julbouln/lifepo4_ups/README

5V/2A LTC4040 and STM32F042/STM32F070 based Lifepo4 UPS

https://www.analog.com/media/en/technical-documentation/data-sheets/4040fb.pdf
https://www.st.com/resource/en/datasheet/stm32f042k6.pdf
