julbouln/lifepo4_ups/hardware/lifepo4_mini_psu.kicad_pcb

## KiCad design hardware/lifepo4_mini_psu.kicad_pcb (2020-08-30)

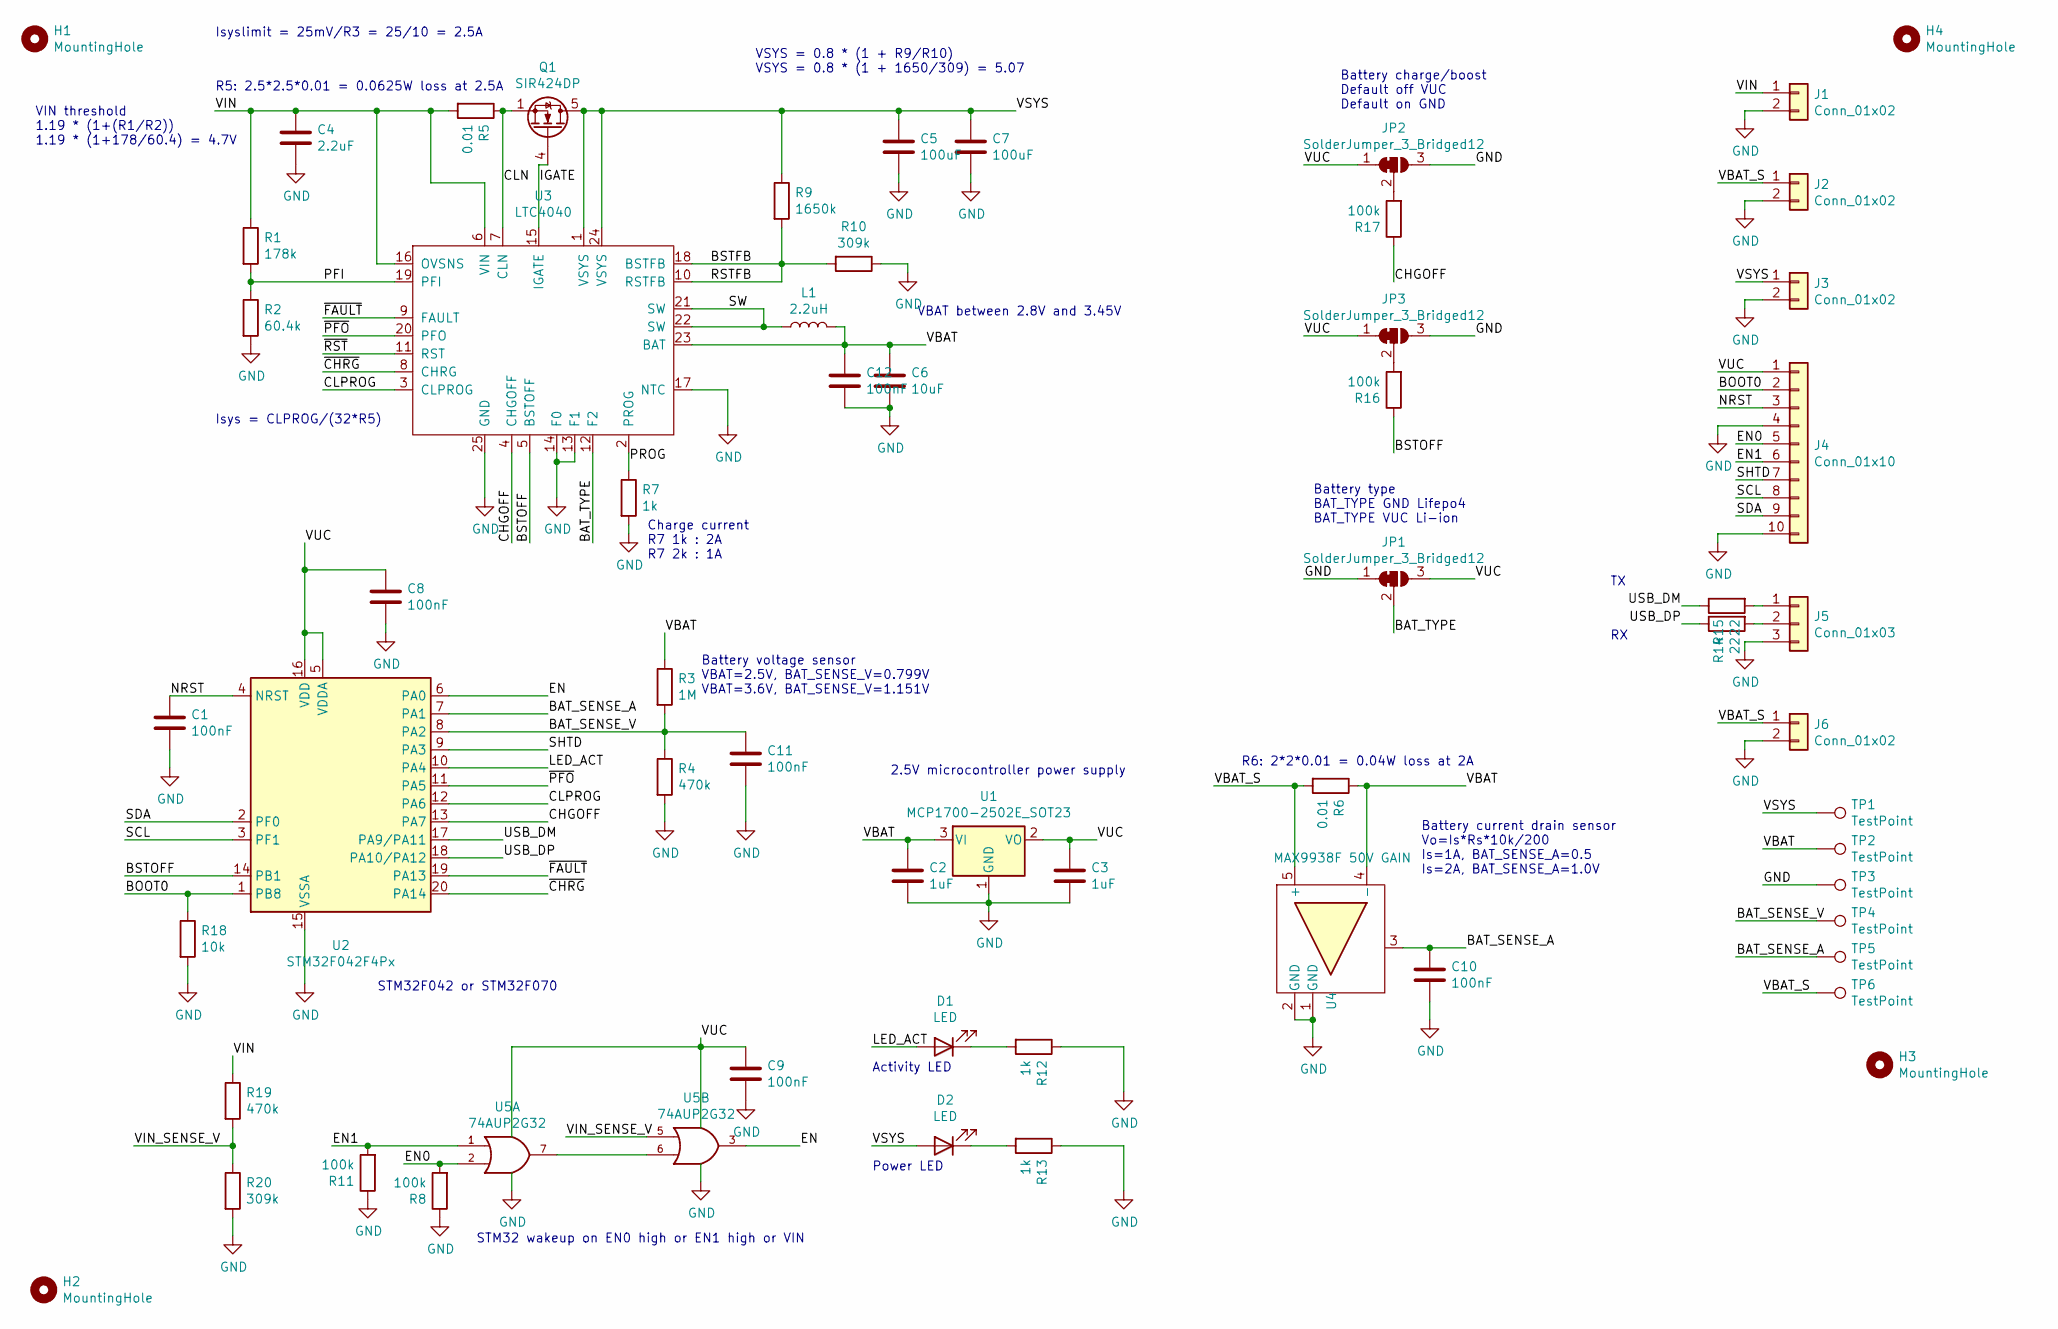
[picture p1: schematic lifepo4_mini_psu.sch, Lifepo4 UPS]

Parts:
C1, C8, C9, C10, C11, C12: 100nF; C_0603_1608Metric_Pad1.05x0.95mm_HandSolder
C2, C3: 1uF; C_0603_1608Metric_Pad1.05x0.95mm_HandSolder
C4: 2.2uF; C_0603_1608Metric_Pad1.05x0.95mm_HandSolder
C5, C7: 100uF; C_1210_3225Metric_Pad1.42x2.65mm_HandSolder
C6: 10uF; C_0603_1608Metric_Pad1.05x0.95mm_HandSolder
D1, D2: LED; LED_0603_1608Metric_Pad1.05x0.95mm_HandSolder
H1, H2, H3, H4: MountingHole; MountingHole_2.7mm_M2.5
J1, J2, J3, J6: Conn_01x02; PinHeader_1x02_P2.54mm_Vertical
J4: Conn_01x10; PinHeader_1x10_P2.54mm_Vertical
J5: Conn_01x03; PinHeader_1x03_P2.54mm_Vertical
JP1, JP2, JP3: SolderJumper_3_Bridged12; SolderJumper-3_P1.3mm_Bridged12_RoundedPad1.0x1.5mm
L1: 2.2uH; L_Coilcraft_XAL5030
Q1: SIR424DP; PowerPAK_SO-8_Single
R1: 178k; R_0603_1608Metric_Pad1.05x0.95mm_HandSolder
R2: 60.4k; R_0603_1608Metric_Pad1.05x0.95mm_HandSolder
R3: 1M; R_0603_1608Metric_Pad1.05x0.95mm_HandSolder
R4, R19: 470k; R_0603_1608Metric_Pad1.05x0.95mm_HandSolder
R5, R6: 0.01; R_1206_3216Metric_Pad1.42x1.75mm_HandSolder
R7, R12, R13: 1k; R_0603_1608Metric_Pad1.05x0.95mm_HandSolder
R8, R11, R16, R17: 100k; R_0603_1608Metric_Pad1.05x0.95mm_HandSolder
R9: 1650k; R_0603_1608Metric_Pad1.05x0.95mm_HandSolder
R10, R20: 309k; R_0603_1608Metric_Pad1.05x0.95mm_HandSolder
R14, R15: 22; R_0603_1608Metric_Pad1.05x0.95mm_HandSolder
R18: 10k; R_0603_1608Metric_Pad1.05x0.95mm_HandSolder
TP1, TP2, TP3, TP4, TP5, TP6: TestPoint; TestPoint_THTPad_D1.0mm_Drill0.5mm
U1: MCP1700-2502E_SOT23; SOT-23
U2: STM32F042F4Px; TSSOP-20_4.4x6.5mm_P0.65mm
U3: LTC4040; QFN-24-1EP_4x5mm_P0.5mm_EP2.65x3.65mm
U4: MAX9938F 50V GAIN; SOT-23-5
U5: 74AUP2G32; VSSOP-8_2.3x2mm_P0.5mm

Connections:
/BAT_SENSE_A: C10.1, TP5.1, U2.7 (PA1), U4.3
/BAT_SENSE_V: C11.1, R3.2, R4.1, TP4.1, U2.8 (PA2)
/BAT_TYPE: JP1.2 (C), U3.12 (F2)
/BOOT0: J4.2, R18.1, U2.1 (PB8)
/BSTFB: R9.2, R10.2, U3.10 (RSTFB), U3.18 (BSTFB)
/BSTOFF: R16.1, U2.14 (PB1), U3.5 (BSTOFF)
/CHGOFF: R17.1, U2.13 (PA7), U3.4 (CHGOFF)
/CLN: Q1.1 (S), Q1.2 (S), Q1.3 (S), R5.1, U3.7 (CLN)
/CLPROG: U2.12 (PA6), U3.3 (CLPROG)
/EN: U2.6 (PA0), U5.3
/EN0: J4.5, R8.2, U5.2
/EN1: J4.6, R11.2, U5.1
/IGATE: Q1.4 (G), U3.15 (IGATE)
/LED_ACT: D1.2 (A), U2.10 (PA4)
/NRST: C1.1, J4.3, U2.4 (NRST)
/PFI: R1.2, R2.1, U3.19 (PFI)
/PROG: R7.1, U3.2 (PROG)
/SCL: J4.8, U2.3 (PF1)
/SDA: J4.9, U2.2 (PF0)
/SHTD: J4.7, U2.9 (PA3)
/SW: L1.1, U3.21 (SW), U3.22 (SW)
/USB_DM: R15.1, U2.17 (PA9/PA11)
/USB_DP: R14.1, U2.18 (PA10/PA12)
/VBAT: C2.1, C6.1, C12.1, L1.2, R3.1, R6.1, TP2.1, U1.3 (VI), U3.23 (BAT), U4.4 (-)
/VBAT_S: J2.1, J6.1, R6.2, TP6.1, U4.5 (+)
/VIN: C4.1, J1.1, R1.1, R5.2, R19.1, U3.6 (VIN), U3.16 (OVSNS)
/VIN_SENSE_V: R19.2, R20.1, U5.5
/VSYS: C5.1, C7.1, D2.2 (A), J3.1, Q1.5 (D), R9.1, TP1.1, U3.1 (VSYS), U3.24 (VSYS)
/~CHRG: U2.20 (PA14), U3.8 (CHRG)
/~FAULT: U2.19 (PA13), U3.9 (FAULT)
/~PFO: U2.11 (PA5), U3.20 (PFO)
/~RST: U3.11 (RST)
GND: C1.2, C2.2, C3.2, C4.2, C5.2, C6.2, C7.2, C8.2, C9.2, C10.2, C11.2, C12.2, J1.2, J2.2, J3.2, J4.4, J4.10, J5.3, J6.2, JP1.1 (A), JP2.3 (B), JP3.3 (B), R2.2, R4.2, R7.2, R8.1, R10.1, R11.1, R12.1, R13.1, R18.2, R20.2, TP3.1, U1.1 (GND), U2.15 (VSSA), U3.13 (F1), U3.14 (F0), U3.17 (NTC), U3.25 (GND), U4.1 (GND), U4.2 (GND), U5.4 (GND)
unnamed: D1.1 (K), R12.2
unnamed: D2.1 (K), R13.2
unnamed: J5.1, R15.2
unnamed: J5.2, R14.2
unnamed: JP2.2 (C), R17.2
unnamed: JP3.2 (C), R16.2
unnamed: U5.6, U5.7
VCC: C3.1, C8.1, C9.1, J4.1, JP1.3 (B), JP2.1 (A), JP3.1 (A), U1.2 (VO), U2.5 (VDDA), U2.16 (VDD), U5.8 (VCC)

Notes on the sheet:
Charge current R7 1k : 2A R7 2k : 1A
Isyslimit = 25mV/R3 = 25/10 = 2.5A
VBAT between 2.8V and 3.45V
Isys = CLPROG/(32*R5)
Battery voltage sensor VBAT=2.5V, BAT_SENSE_V=0.799V VBAT=3.6V, BAT_SENSE_V=1.151V
Battery current drain sensor Vo=Is*Rs*10k/200 Is=1A, BAT_SENSE_A=0.5 Is=2A, BAT_SENSE_A=1.0V
Battery charge/boost Default off VUC Default on GND
R6: 2*2*0.01 = 0.04W loss at 2A
R5: 2.5*2.5*0.01 = 0.0625W loss at 2.5A
VIN threshold 1.19 * (1+(R1/R2)) 1.19 * (1+178/60.4) = 4.7V
VSYS = 0.8 * (1 + R9/R10) VSYS = 0.8 * (1 + 1650/309) = 5.07
2.5V microcontroller power supply
STM32 wakeup on EN0 high or EN1 high or VIN
Power LED
Activity LED
Battery type BAT_TYPE GND Lifepo4 BAT_TYPE VUC Li-ion
STM32F042 or STM32F070

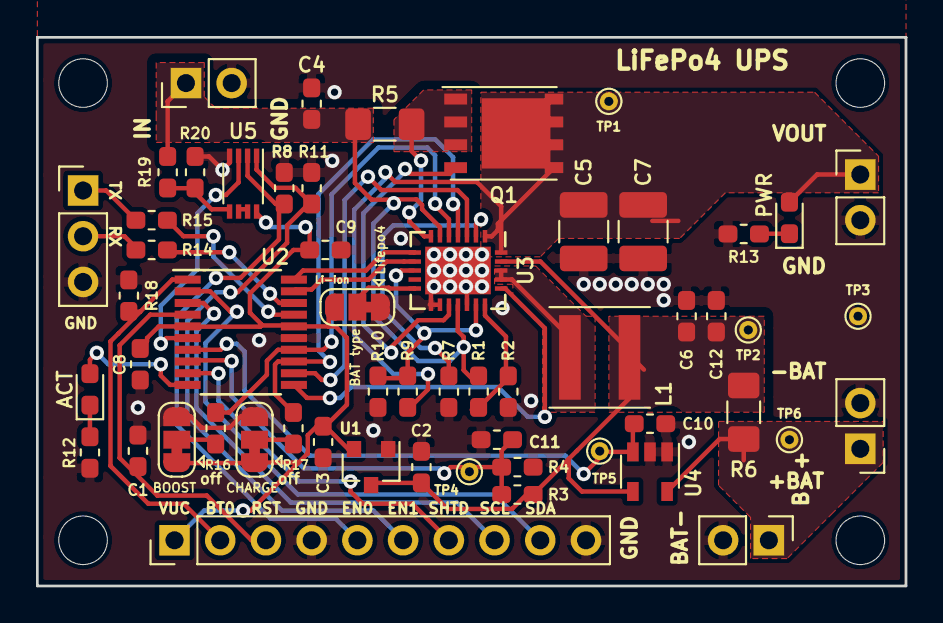
[picture p2: board lifepo4_mini_psu.kicad_pcb from above]

Board: 2 copper layers, 48.3 x 30.5 mm, 60 parts (0 on the bottom side), 40 nets.
