julbouln/lifepo4_ups/(notices)

Notices in the files:
firmware/rtc.c:
This library is free software: you can redistribute it and/or modify
it under the terms of the GNU Lesser General Public License as published by
the Free Software Foundation, either version 3 of the License, or
(at your option) any later version.
